aranyoray/remorehab/renders/gasket.png

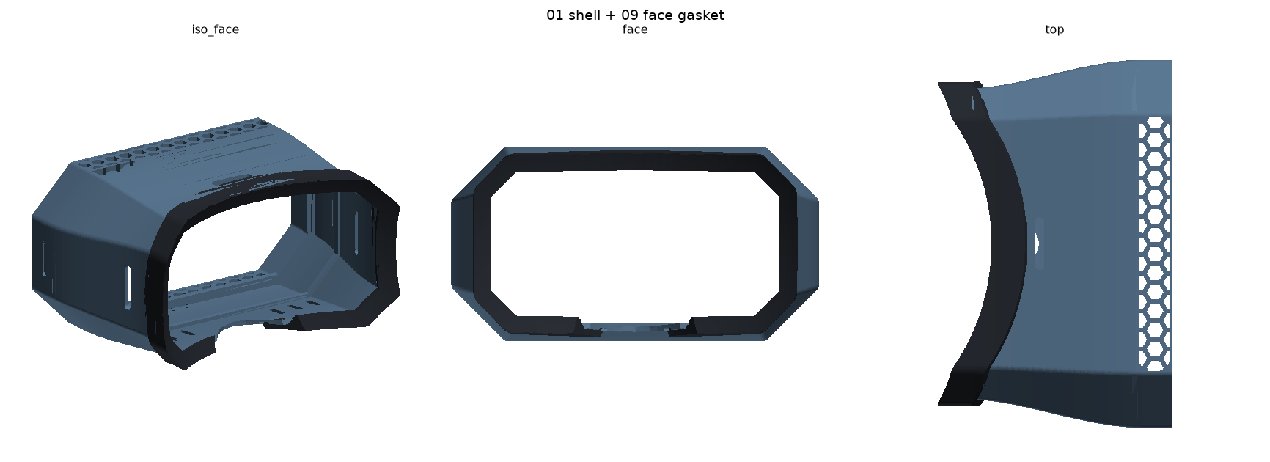
renders/gasket.png
