aranyoray/remorehab/renders/lens-pod.png

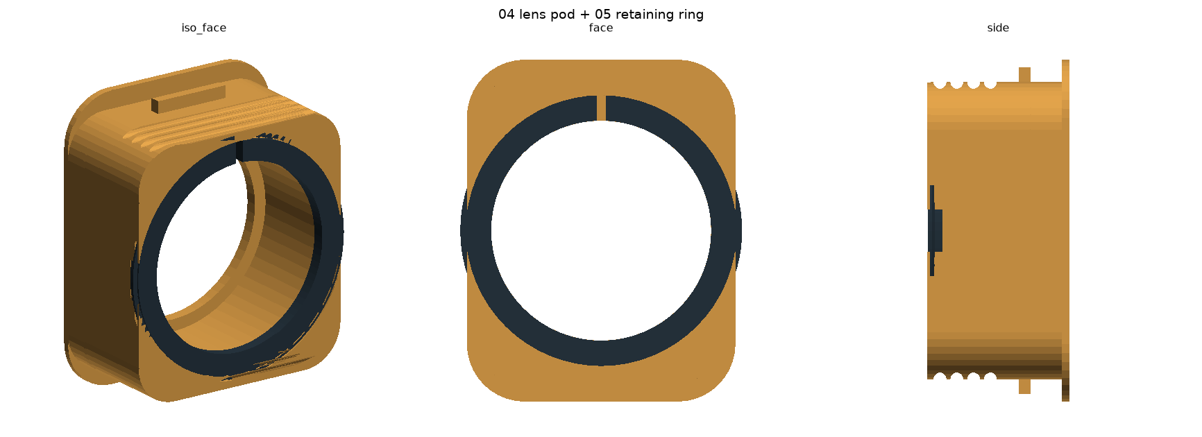
renders/lens-pod.png
