aranyoray/remorehab/renders/shell.png

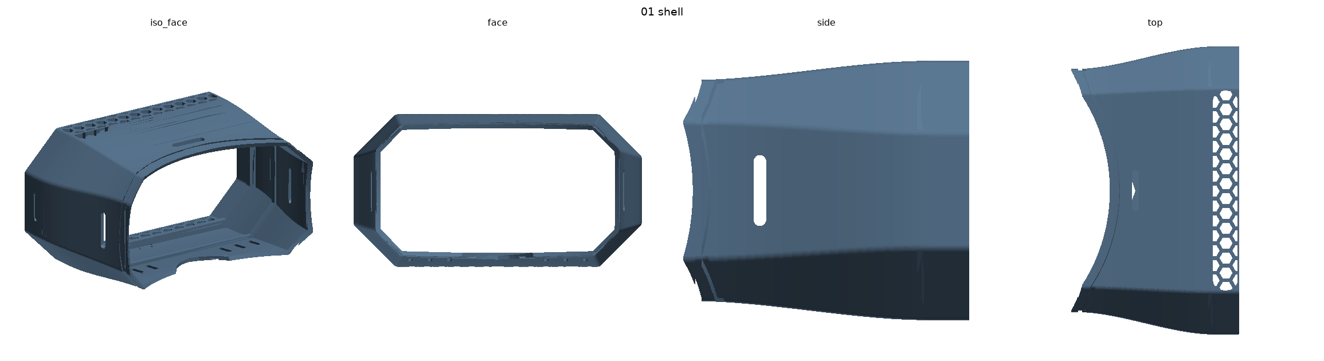
renders/shell.png
