aranyoray/remorehab/stl/01_shell.stl

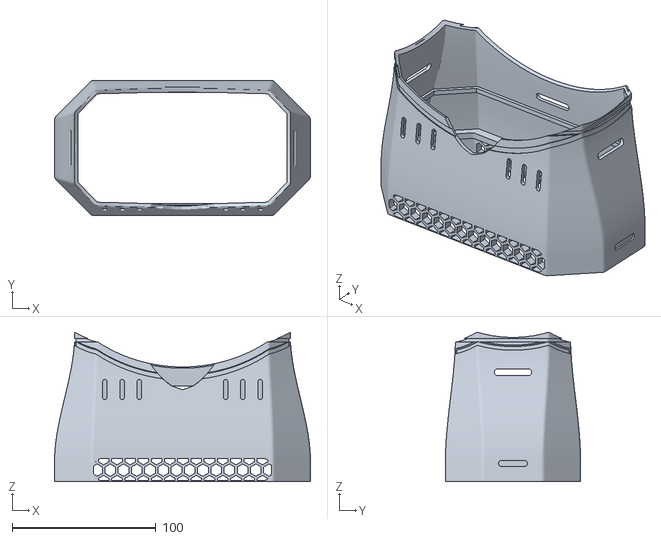
[picture p4: CAD file, 2026-10-21]
stl/01_shell.stl
178.0 x 94.0 x 103.7
