aranyoray/remorehab/stl/06_septum.stl

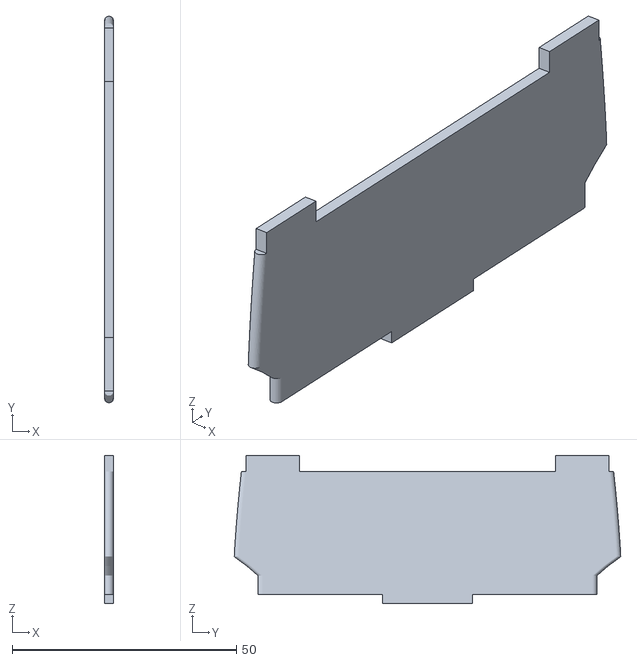
[picture p5: CAD file, 2026-10-21]
stl/06_septum.stl
2.00 x 86.2 x 33.0
