aranyoray/remorehab/stl/09_face_gasket.stl

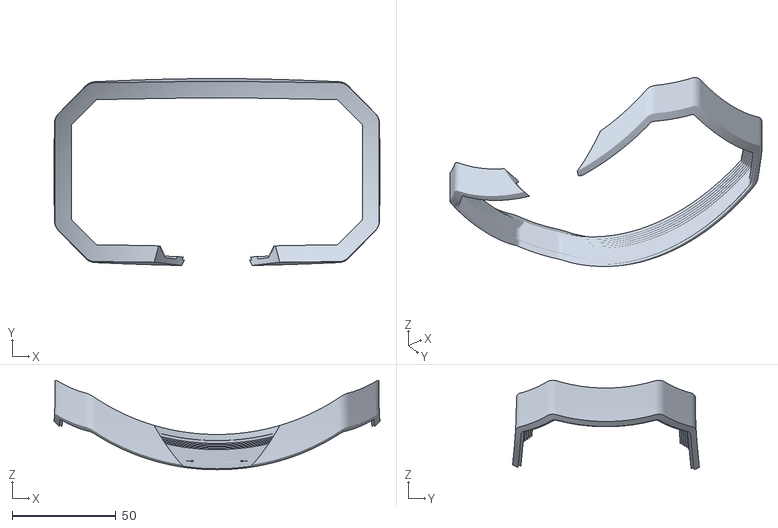
[picture p6: CAD file, 2026-10-21]
stl/09_face_gasket.stl
157.1 x 90.1 x 43.1
