aranyoray/remorehab/stl/08_phone_spacer.stl

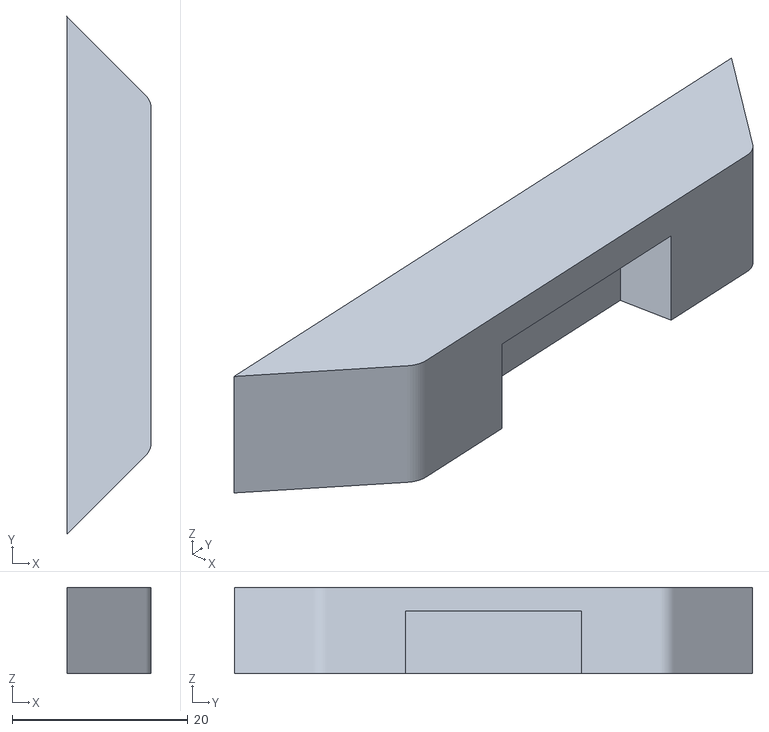
[picture p7: CAD file, 2026-10-21]
stl/08_phone_spacer.stl
9.60 x 58.9 x 9.80
