aranyoray/remorehab/stl/05_lens_ring.stl

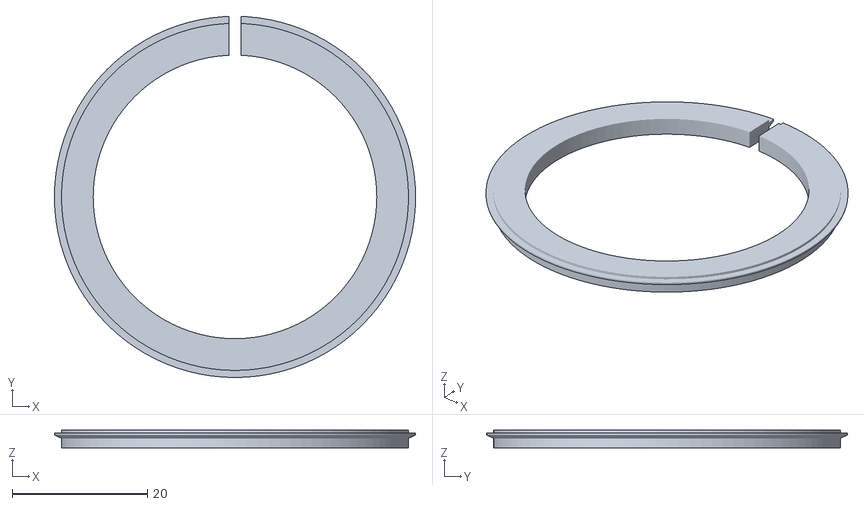
[picture p8: CAD file, 2026-10-21]
stl/05_lens_ring.stl
53.5 x 53.5 x 2.60
