aranyoray/remorehab/stl/07_door.stl

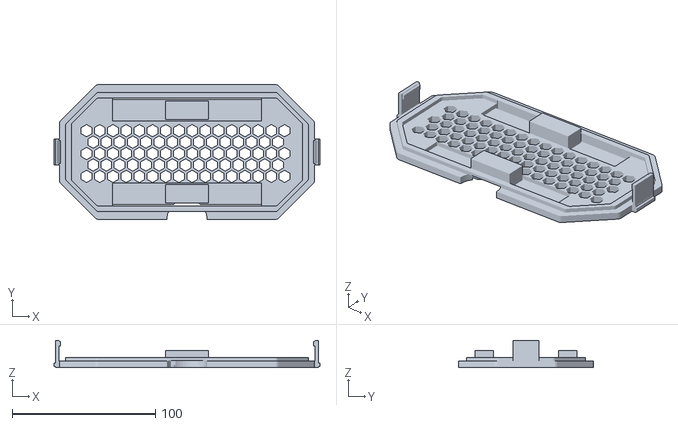
[picture p9: CAD file, 2026-10-21]
stl/07_door.stl
185.4 x 94.0 x 19.1
