aranyoray/remorehab/stl/04_lens_pod.stl

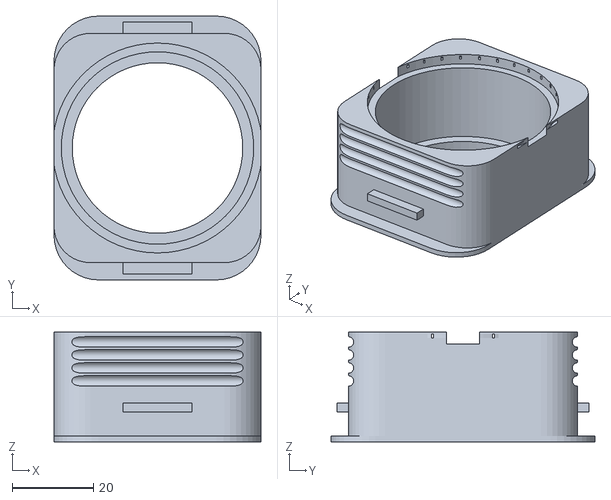
[picture p10: CAD file, 2026-10-21]
stl/04_lens_pod.stl
51.0 x 65.0 x 27.0
