aranyoray/remorehab/stl/11_focus_shim.stl

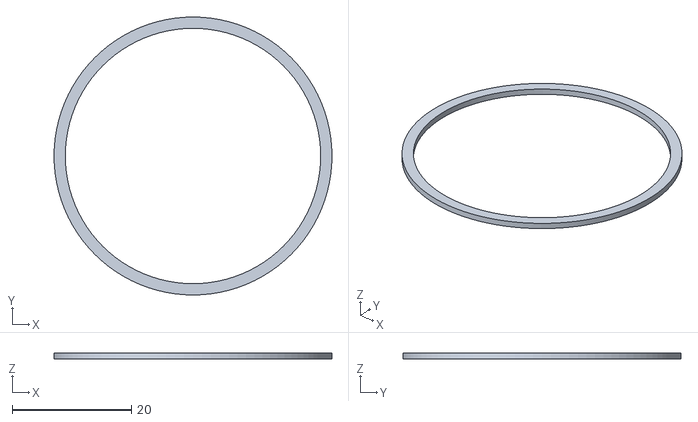
[picture p11: CAD file, 2026-10-21]
stl/11_focus_shim.stl
46.6 x 46.6 x 1.00
