aranyoray/remorehab/stl/10_strap_buckle.stl

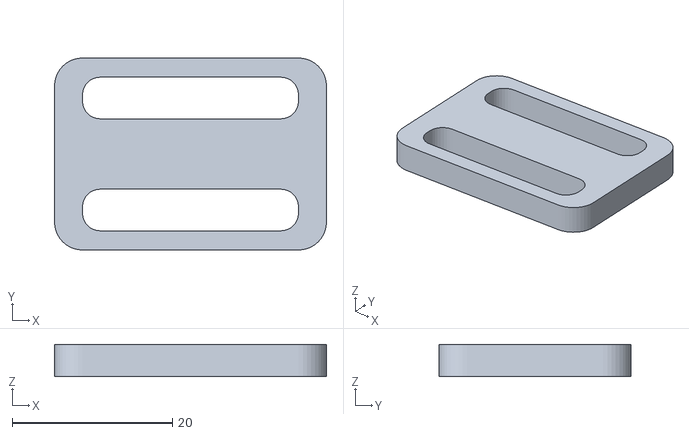
[picture p12: CAD file, 2026-10-21]
stl/10_strap_buckle.stl
34.0 x 24.0 x 4.00
