aranyoray/remorehab/stl/02_screen_mask.stl

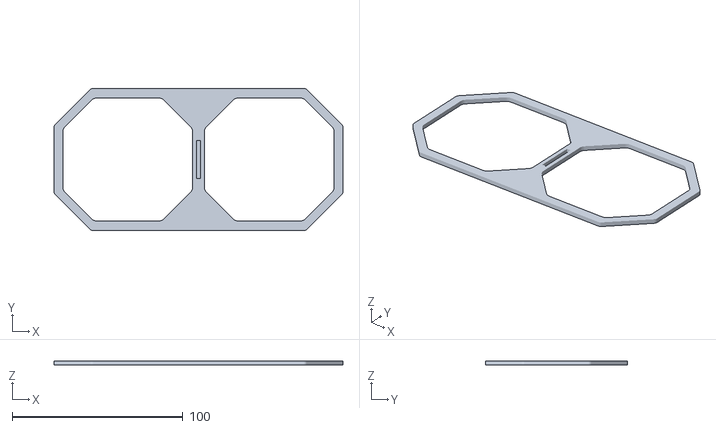
[picture p13: CAD file, 2026-10-21]
stl/02_screen_mask.stl
169.4 x 83.4 x 2.60
