aranyoray/remorehab/stl/03_lens_carrier.stl

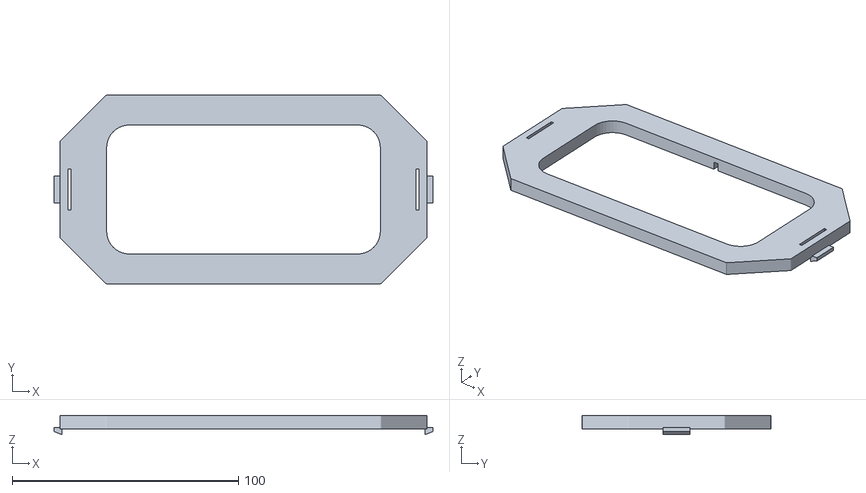
[picture p14: CAD file, 2026-10-21]
stl/03_lens_carrier.stl
167.6 x 83.4 x 8.60
