aranyoray/remorehab/(commit log)

2026-10-21 ReMoRehab: mirror-therapy web app and open printable headset
    Congressional App Challenge entry for Maryland's 1st district.
    - app/: browser mirror-therapy session. Mirrors the working limb across the
    centre line, paces timed sets with an audible cue, counts reps, logs sessions
    to localStorage, and has a stereo mode for the printed headset. Camera frames
    are drawn to a canvas and never leave the device.
    - stl/ + headset-source/: 11-part printable shroud, 56-68 mm adjustable lens
    spacing, generated by a parametric model rather than hand-edited meshes.
    - data/: every figure on the site with its source, data year and limitations,
    including the evidence that weakens the case.
    County h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
2026-10-21 Use the account's canonical Pages domain, and force https for camera access
    GitHub Pages serves this under the account-level custom domain, so the
    aranyoray.github.io URLs written into the site and README were wrong. Replaced
    with https://www.aranyoing.com/remorehab/ and added canonical and og:url tags.
    https is served but not enforced on that domain, and browsers refuse camera
    access on an insecure origin, so the app now upgrades http to https before
    anything else runs. The camera failure message also says which of the likely
    causes it hit instead of printing a bare DOMException name.
